farc0001/TecnoAlarcos/README.md

# TecnoAlarcos
Página de repositorio para el Departamento de Tecnología del I.E.S. Santa María de Alarcos de Ciudad Real
## Índice
1.-Concurso de robótica de la UCLM.

2.-Proyectos aprendizaje Servicio (PaS).
