farc0001/TecnoAlarcos/Concurso_Robotica_UCLM/Software/README.md

# PROGRAMAS DEL ROBOT VEHÍCULO PARA WRO
Programas para el robot tipo vehículo para la competición WRO de la UCLM
Simulador https://wokwi.com/projects/new/esp32
