farc0001/TecnoAlarcos/PaS/README.md

# PROYECTOS DE APRENDIZAJE Y SERVICIO
Los proyectos de aprendizaje y servicio PaS iniciados por el Departamento de Tecnología del IES Santa María de Alarcos de Ciudad Real son:
* Robotic: aprendemos programación y robótica enseñando.
* Robótica en el cole.
* Programación accesible e inclusiva
* FABLAB - Alarcos
