farc0001/TecnoAlarcos/Concurso_Robotica_UCLM/CAD_3D/README.md

# DISEÑO DE PIEZAS DEL ROBOT VEHÍCULO PARA WRO
Repositorio de piezas del robot-vehiculo para la competición de WRO


## Versión 3 (18/05/2026)

Mejora del robot con todos los componentes
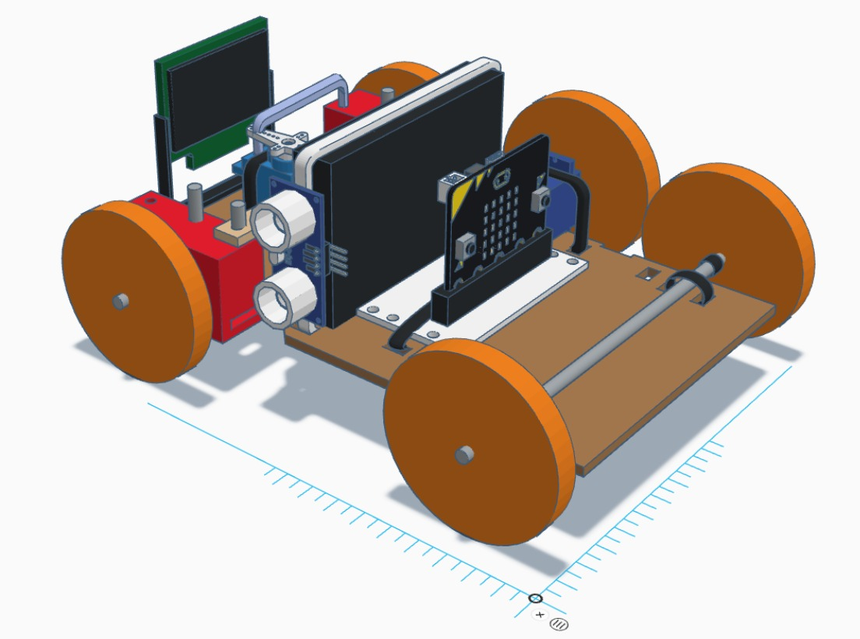
[picture p1: Concurso_Robotica_UCLM/CAD_3D/Robot-WRO-AlarcosV3_3D_1.jpeg]
