farc0001/TecnoAlarcos/Concurso_Robotica_UCLM/CAD_3D/V4/dire1.stl

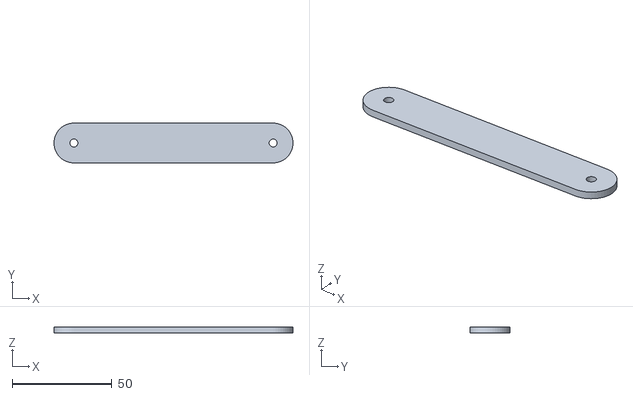
[picture p2: CAD file, 2026-05-31]
Concurso_Robotica_UCLM/CAD_3D/V4/dire1.stl
120.0 x 20.0 x 3.00
