farc0001/TecnoAlarcos/Concurso_Robotica_UCLM/CAD_3D/V4/Copydire1.stl

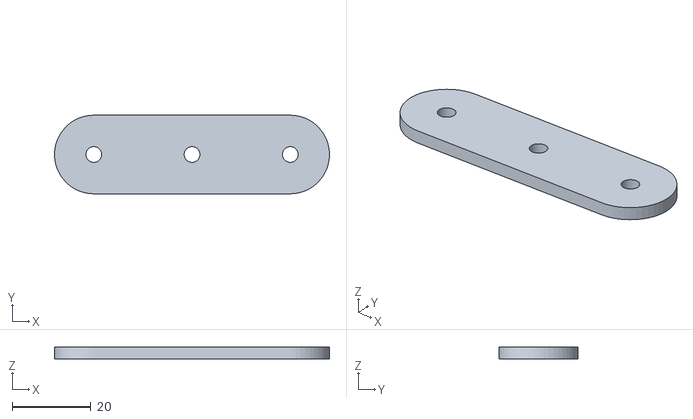
[picture p3: CAD file, 2026-05-31]
Concurso_Robotica_UCLM/CAD_3D/V4/Copydire1.stl
70.0 x 20.0 x 3.00
