farc0001/TecnoAlarcos/Concurso_Robotica_UCLM/CAD_3D/V4/Chasis.stl

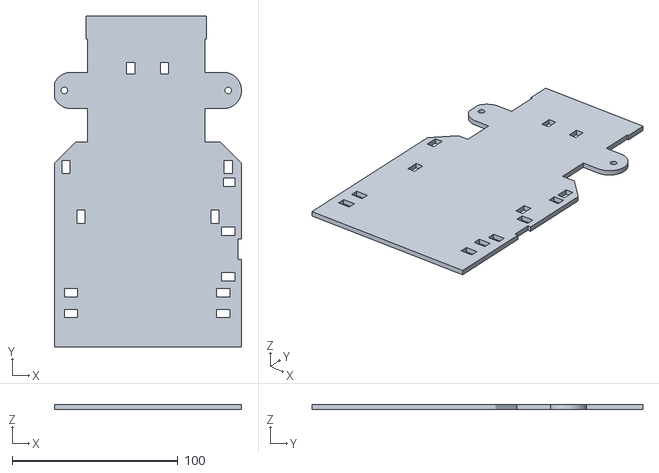
[picture p4: CAD file, 2026-05-31]
Concurso_Robotica_UCLM/CAD_3D/V4/Chasis.stl
113.0 x 200.0 x 3.00
