farc0001/TecnoAlarcos/Concurso_Robotica_UCLM/CAD_3D/V4/Engrane.stl

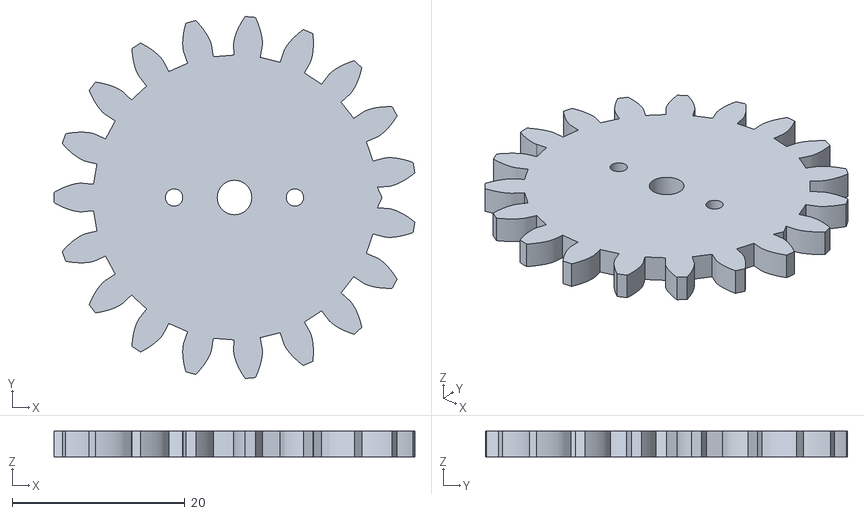
[picture p5: CAD file, 2026-05-31]
Concurso_Robotica_UCLM/CAD_3D/V4/Engrane.stl
41.8 x 41.9 x 3.00
