farc0001/TecnoAlarcos/Concurso_Robotica_UCLM/CAD_3D/V3/Robot-WRO-AlarcosV3.stl

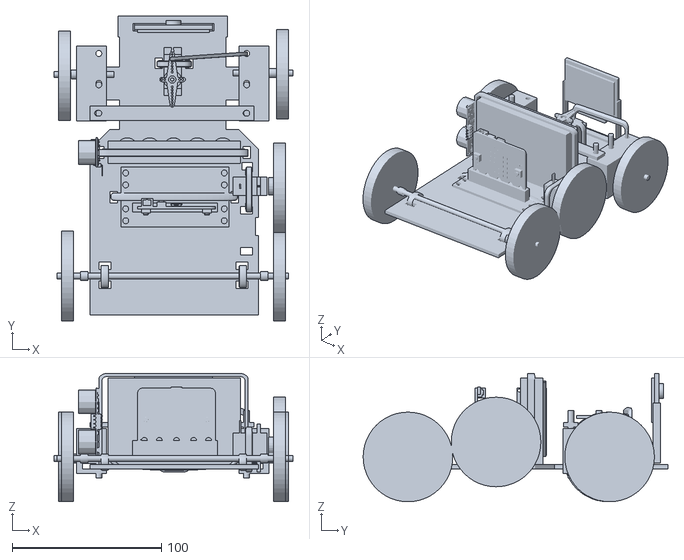
[picture p6: CAD file, 2026-05-17, an earlier design]
Concurso_Robotica_UCLM/CAD_3D/V3/Robot-WRO-AlarcosV3.stl
160.0 x 204.0 x 86.0
