farc0001/TecnoAlarcos/Concurso_Robotica_UCLM/CAD_3D/V3/Robot-WRO-Alarcos1.stl

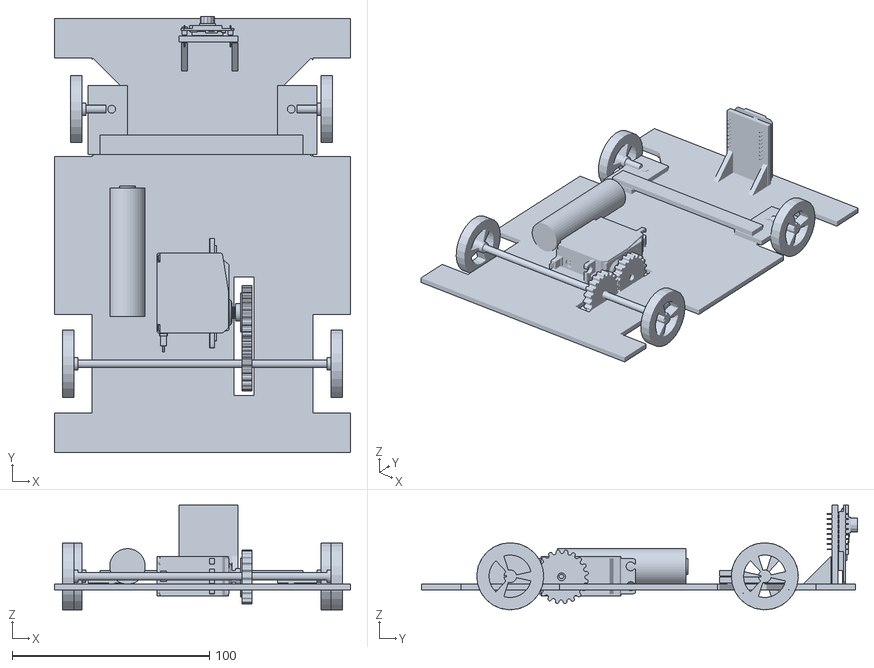
[picture p7: CAD file, 2026-04-22, an earlier design]
Concurso_Robotica_UCLM/CAD_3D/V3/Robot-WRO-Alarcos1.stl
150.0 x 221.0 x 53.0
