farc0001/TecnoAlarcos/(commit log)

2026-05-17 Add files via upload
    Versión 3
    [Robot-WRO-AlarcosV3.stl]
2026-05-31 Enhance README with WRO 2026 project details
    Expanded README with detailed documentation for WRO 2026 autonomous vehicle project, including mechanical design, power architecture, software strategy, and engineering decisions.
